jadenbehringer/Luminos-Space-Habitation-Lighting-System/prototype condensedd.png

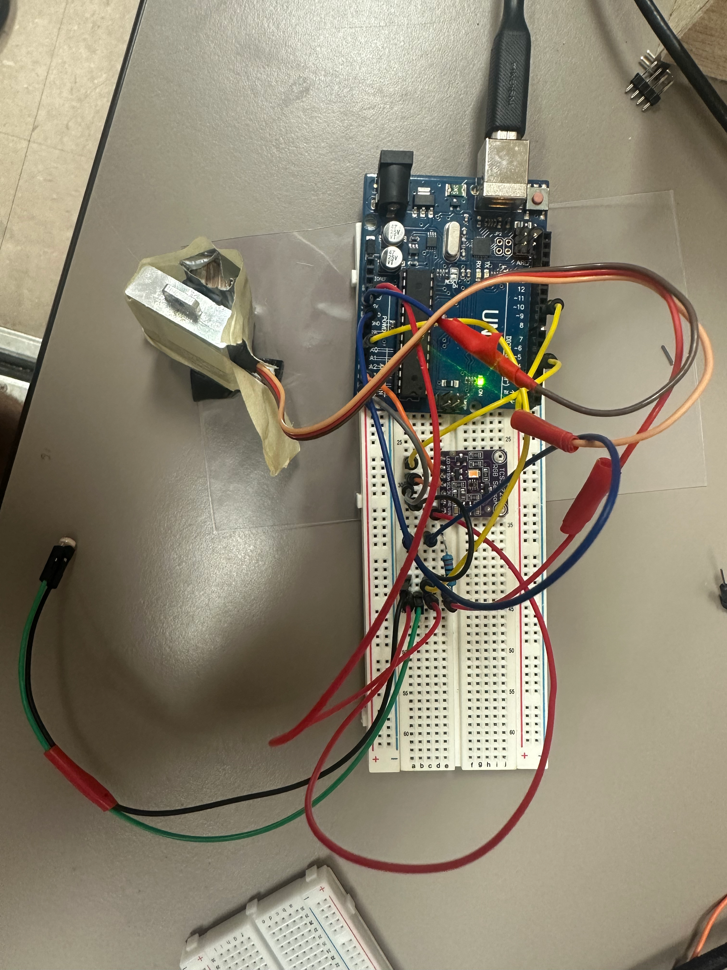
prototype condensedd.png
