jadenbehringer/Luminos-Space-Habitation-Lighting-System/(commit log)

2026-04-23 Initialize AERO_636_proj with arduino-ui subfolder
2026-04-23 filter from ui is working
2026-04-23 servo better
2026-10-19 Replace design docs and SVG wiring diagram with prototype PDF and PNG
    Untrack .DS_Store.
